OmerNazir/CustomParts/3D/Battery_A_size_3_pin.step

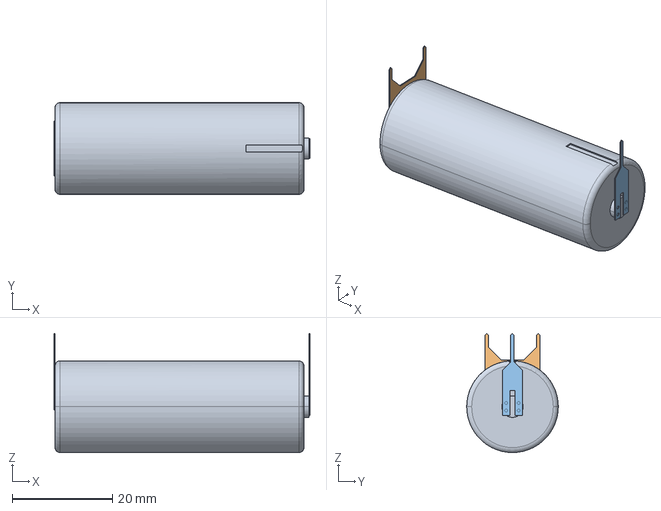
[picture p1: CAD file, 2024-05-29]
3D/Battery_A_size_3_pin.step
51.1 x 18.3 x 23.8 mm
