OmerNazir/CustomParts/3D/Inductor_Custom_1.5mH.step

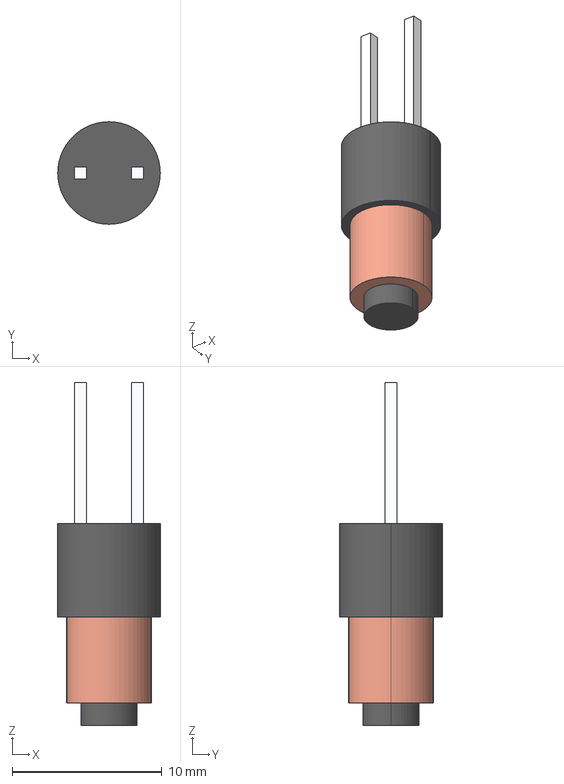
[picture p2: CAD file, 2024-04-29]
3D/Inductor_Custom_1.5mH.step
6.85 x 6.85 x 22.9 mm
