OmerNazir/CustomParts/3D/Connector_Molex_SPOX_5267-03A_1x03_P2.50mm_Vertical.step

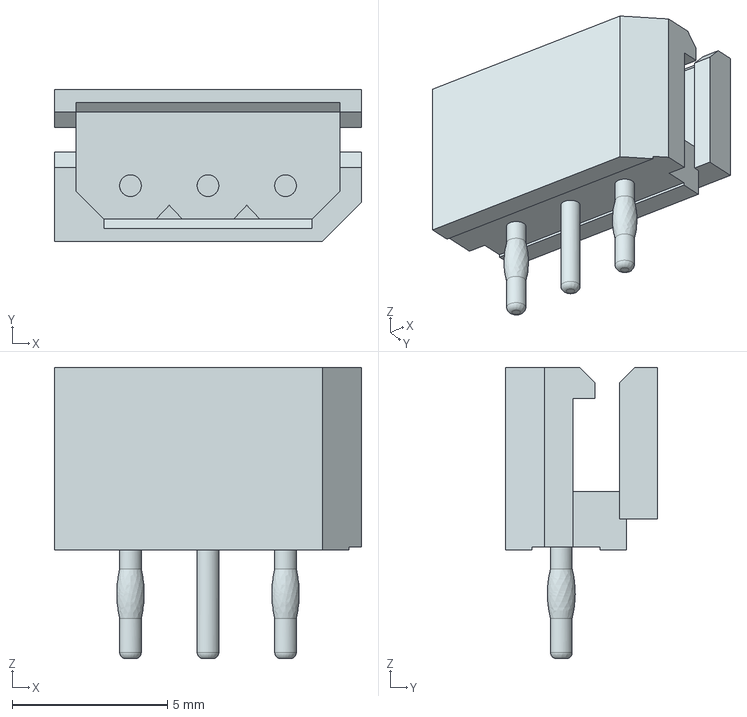
[picture p3: CAD file, 2024-04-16]
3D/Connector_Molex_SPOX_5267-03A_1x03_P2.50mm_Vertical.step
9.90 x 4.90 x 9.40 mm
