OmerNazir/CustomParts/3D/Connector_Molex_SPOX_5267-02A_1x02_P2.50mm_Vertical.step

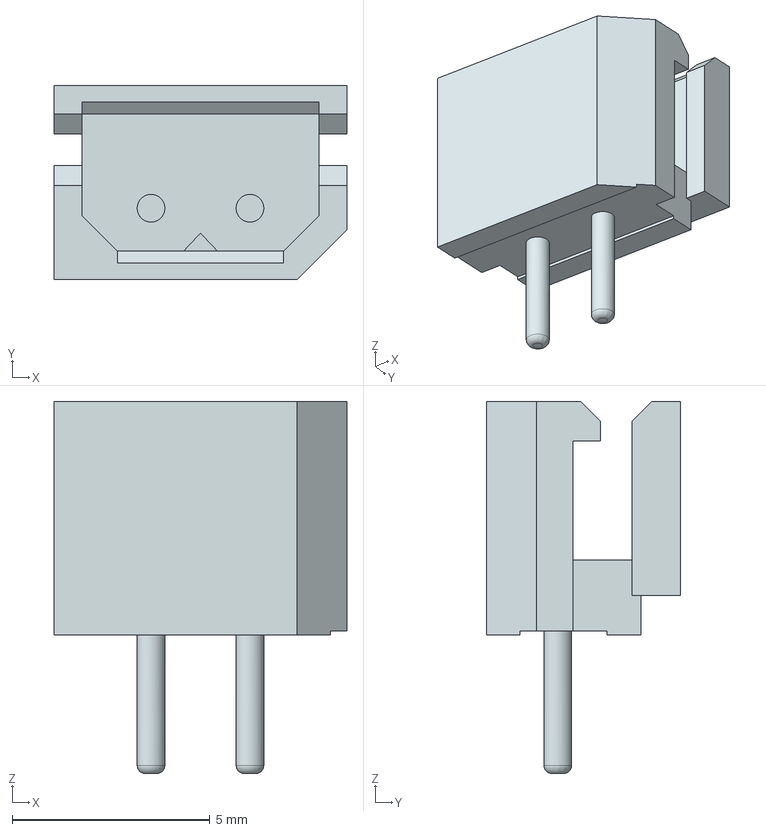
[picture p4: CAD file, 2024-04-16]
3D/Connector_Molex_SPOX_5267-02A_1x02_P2.50mm_Vertical.step
7.40 x 4.90 x 9.40 mm
