OmerNazir/CustomParts/3D/Connector_Molex_SPOX_5267-04A_1x04_P2.50mm_Vertical.step

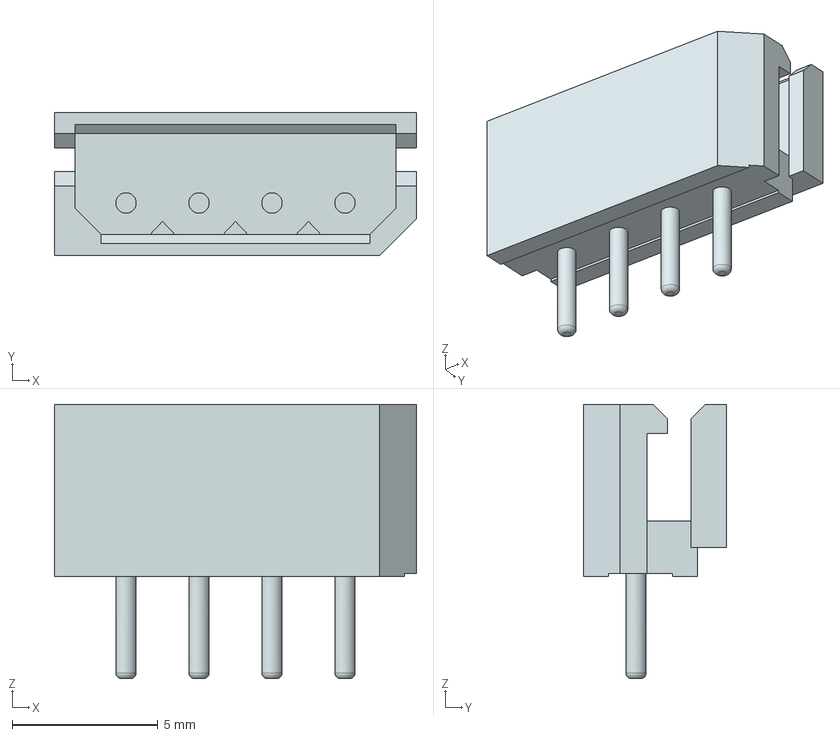
[picture p5: CAD file, 2024-04-16]
3D/Connector_Molex_SPOX_5267-04A_1x04_P2.50mm_Vertical.step
12.4 x 4.90 x 9.40 mm
