OmerNazir/CustomParts/3D/Connector_Molex_SPOX_5267-06A_1x06_P2.50mm_Vertical.step

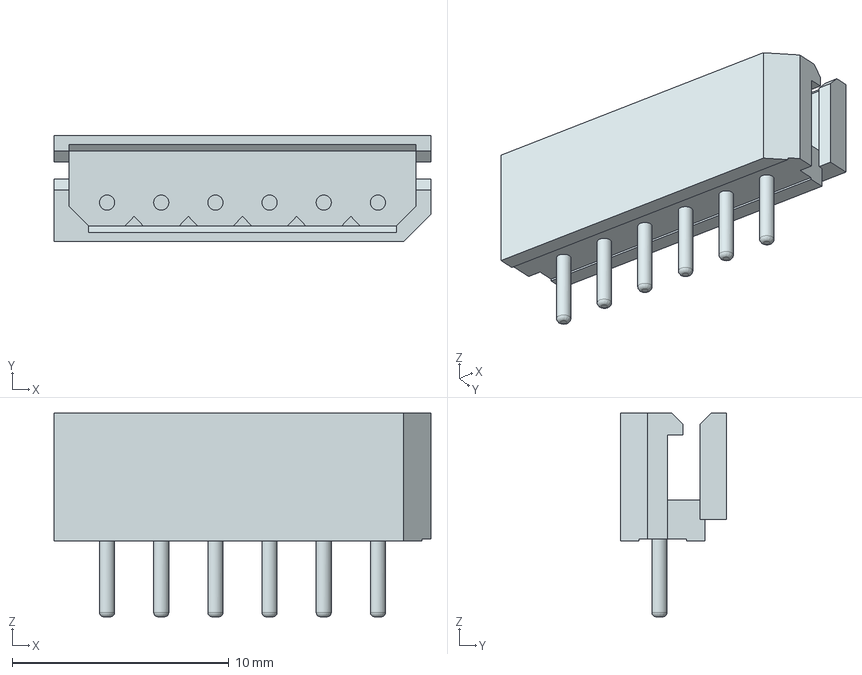
[picture p6: CAD file, 2024-04-16]
3D/Connector_Molex_SPOX_5267-06A_1x06_P2.50mm_Vertical.step
17.4 x 4.90 x 9.40 mm
