OmerNazir/CustomParts/3D/Switch_Micro.step

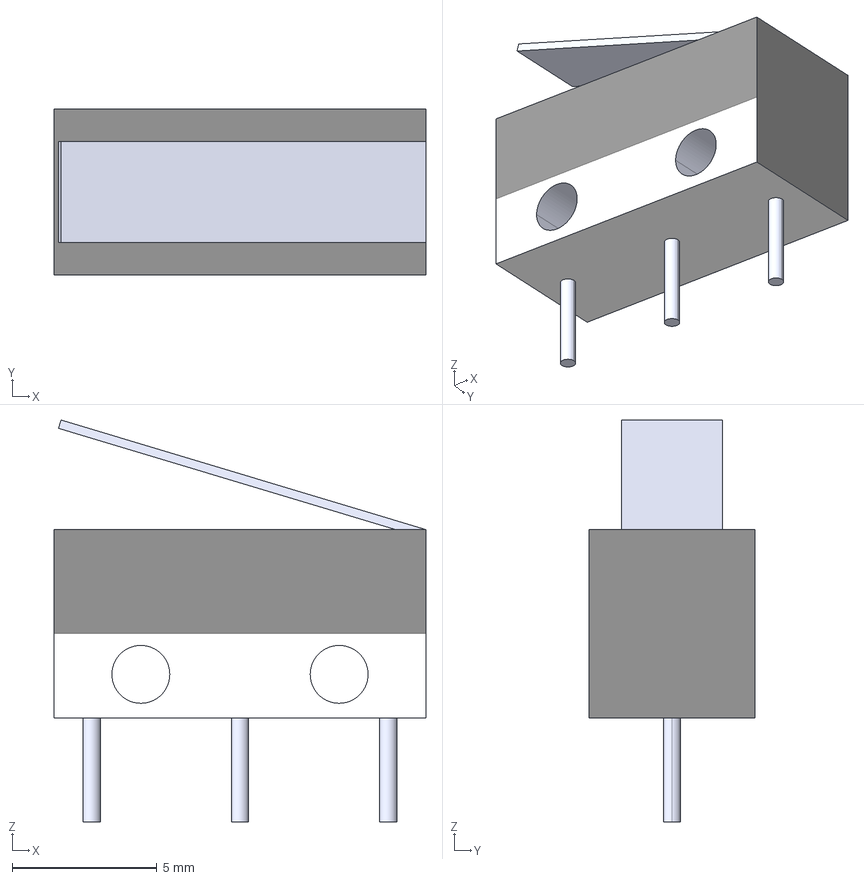
[picture p7: CAD file, 2024-04-16]
3D/Switch_Micro.step
12.9 x 5.75 x 13.9 mm
