OmerNazir/CustomParts/3D/Connector_Molex_SPOX_5267-05A_1x05_P2.50mm_Vertical.step

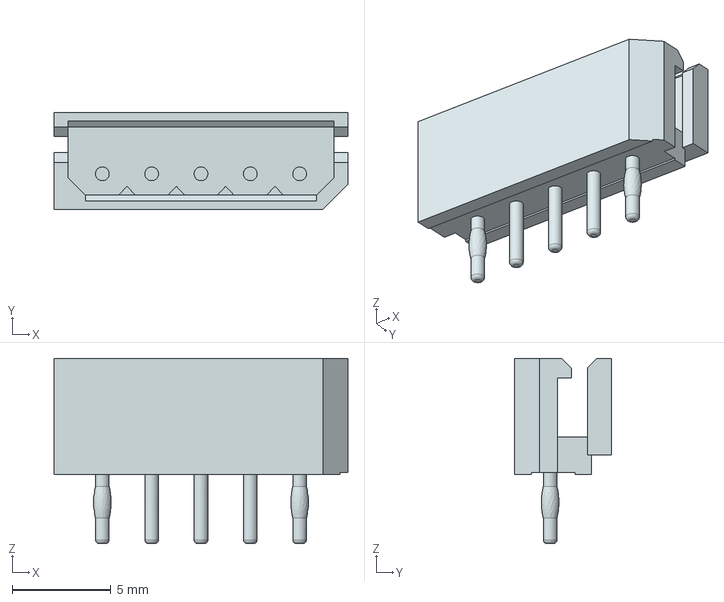
[picture p8: CAD file, 2024-04-16]
3D/Connector_Molex_SPOX_5267-05A_1x05_P2.50mm_Vertical.step
14.9 x 4.90 x 9.40 mm
