OmerNazir/CustomParts/3D/Connector_ETH_1GB_7499511420.step

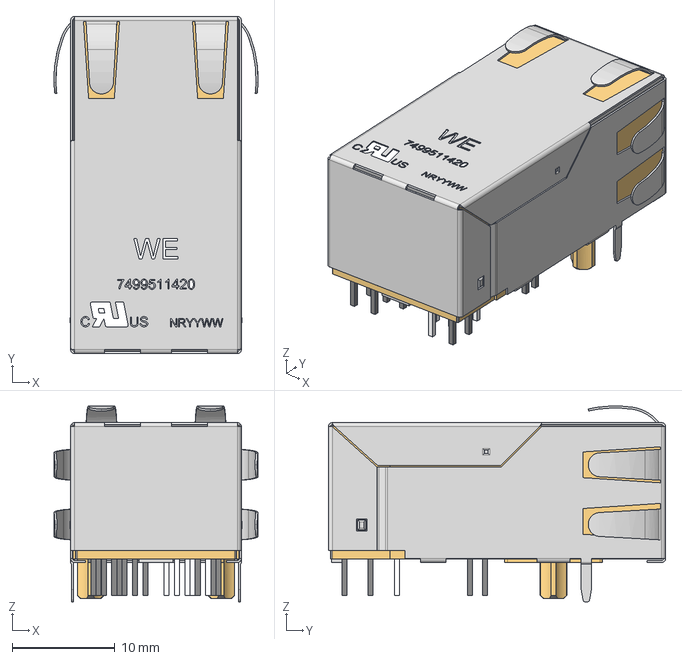
[picture p9: CAD file, 2024-03-22]
3D/Connector_ETH_1GB_7499511420.step
19.8 x 32.8 x 19.0 mm
