OmerNazir/CustomParts/3D/USB_TYPE_B_AMPHENOL_61729-0010BLF.STEP

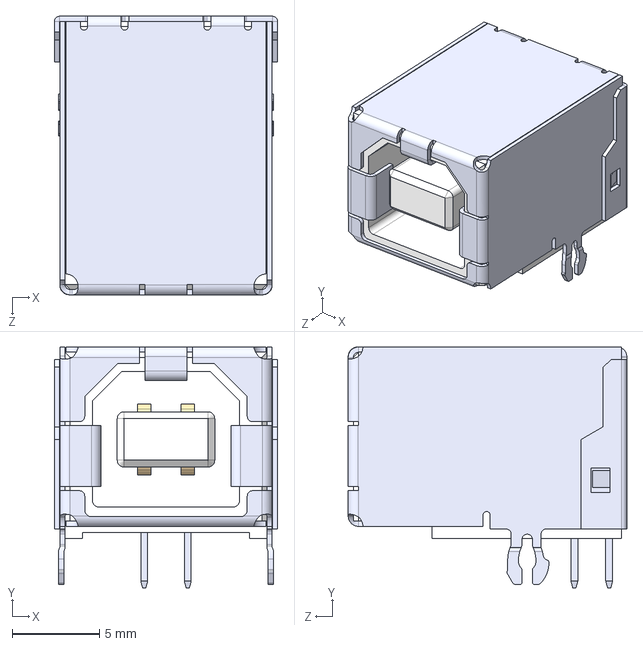
[picture p10: CAD file, 2024-03-22]
3D/USB_TYPE_B_AMPHENOL_61729-0010BLF.STEP
12.8 x 13.8 x 16.0 mm
