OmerNazir/CustomParts/3D/QFP44- 10x10.STEP

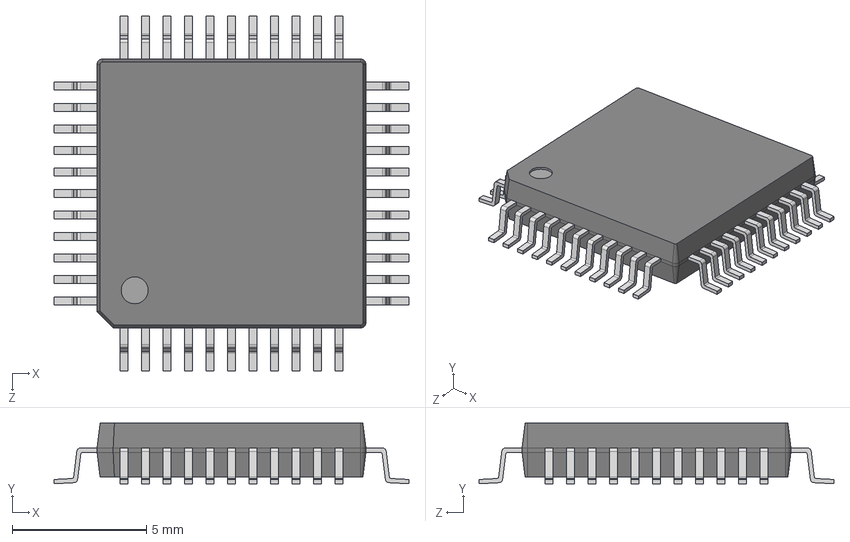
[picture p11: CAD file, 2024-03-22]
3D/QFP44- 10x10.STEP
13.2 x 2.25 x 13.2 mm
