OmerNazir/CustomParts/3D/Tact Switch 4.5mm SMT.step

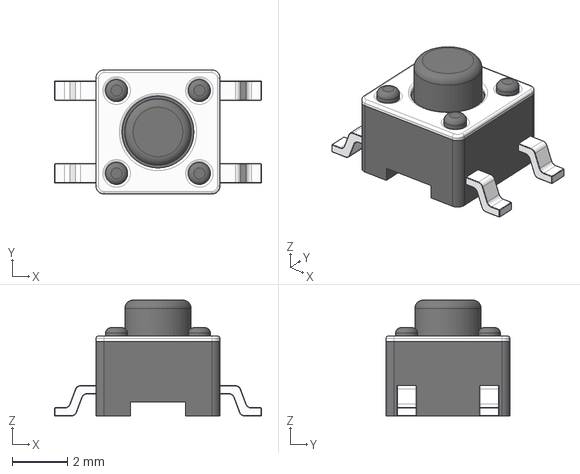
[picture p12: CAD file, 2024-03-22]
3D/Tact Switch 4.5mm SMT.step
7.50 x 4.50 x 4.20 mm
