OmerNazir/CustomParts/3D/MAX3232ECTET.step

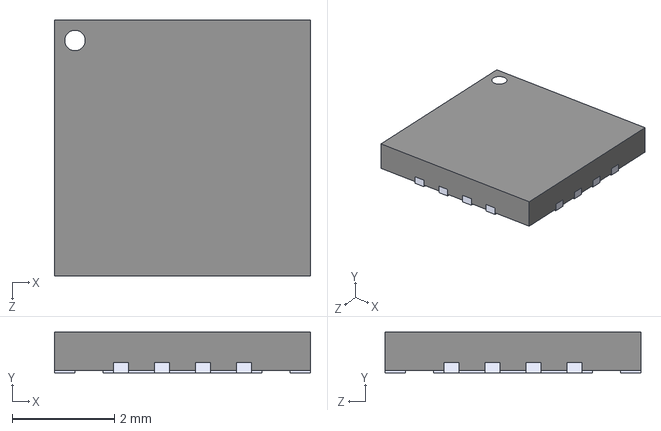
[picture p13: CAD file, 2024-03-22]
3D/MAX3232ECTET.step
5.00 x 0.8 x 5.00 mm
