OmerNazir/CustomParts/3D/HDMI_A_AMPHENOL_10029449-111RLF.step

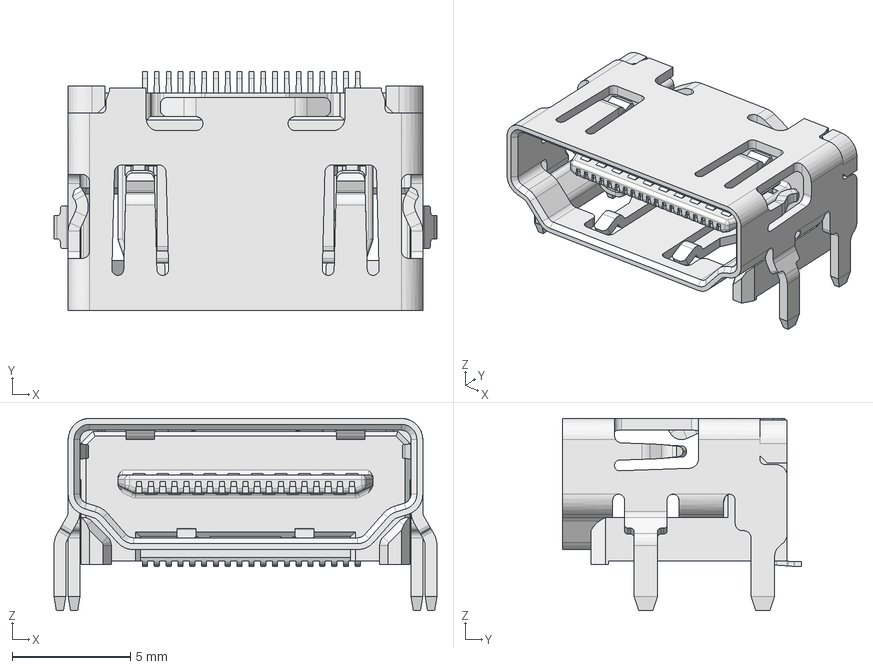
[picture p14: CAD file, 2024-03-22]
3D/HDMI_A_AMPHENOL_10029449-111RLF.step
16.2 x 10.1 x 8.13 mm
