OmerNazir/CustomParts/3D/LAN_TRANSFORMER_7490220122_WRE.step

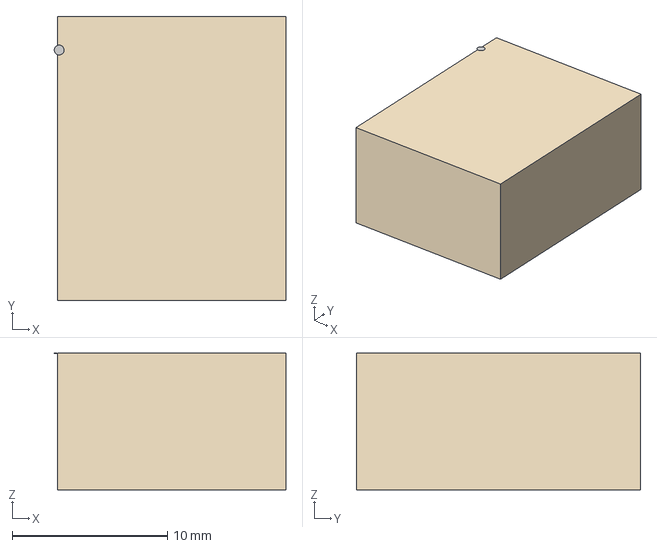
[picture p15: CAD file, 2024-03-22]
3D/LAN_TRANSFORMER_7490220122_WRE.step
14.9 x 18.3 x 8.82 mm
