OmerNazir/CustomParts/3D/connector_BarrelJack_GCT_DCJ200_10_A_Horizontal.step

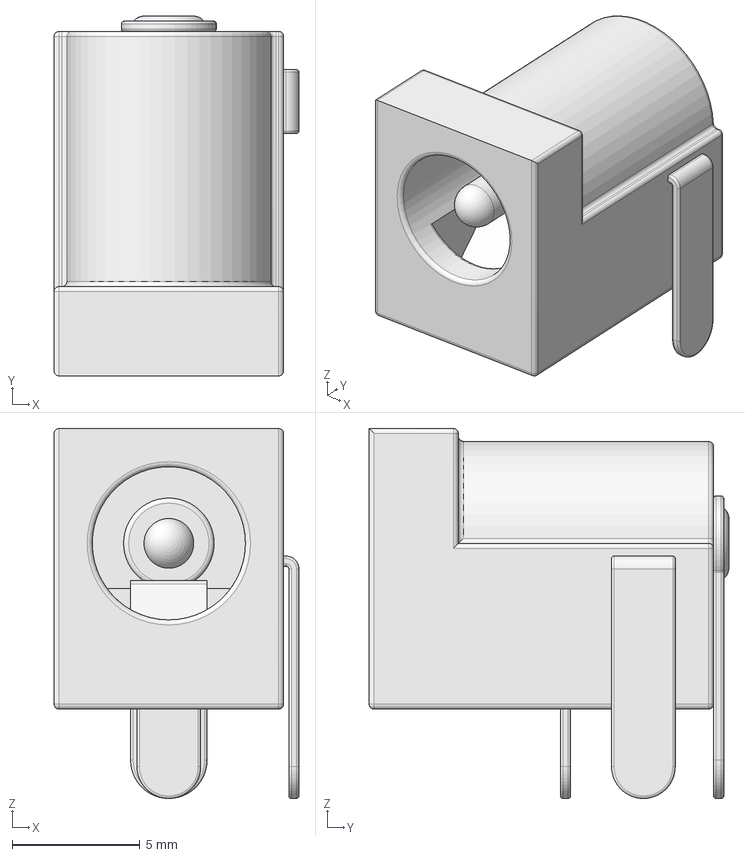
[picture p16: CAD file, 2024-03-22]
3D/connector_BarrelJack_GCT_DCJ200_10_A_Horizontal.step
9.60 x 14.1 x 14.5 mm
