OmerNazir/CustomParts/3D/USB_A_DOUBLE_STACK_61400826021 (rev1).stp

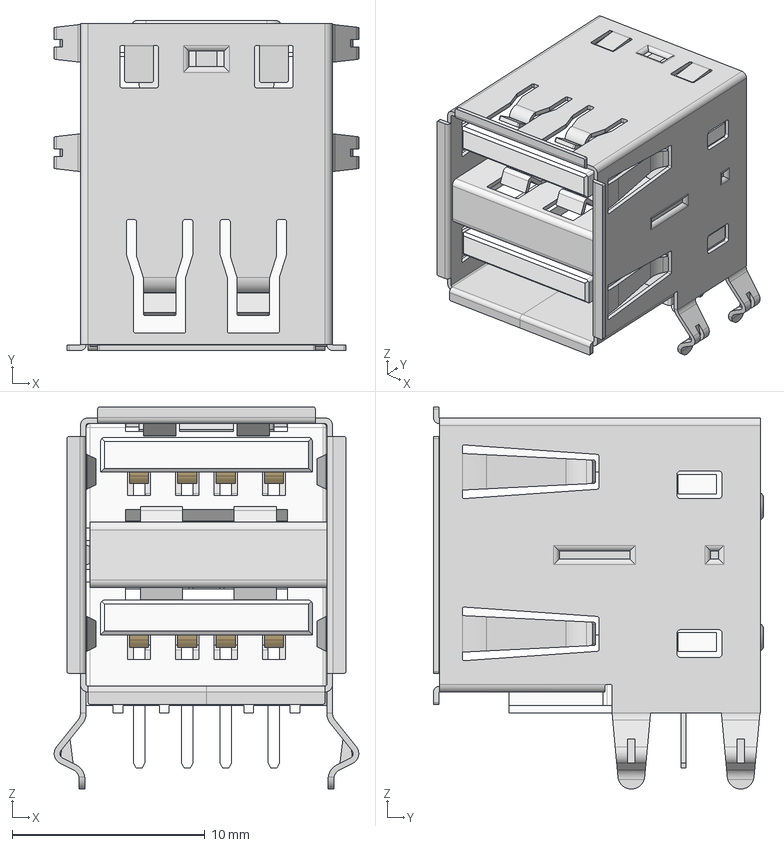
[picture p17: CAD file, 2024-03-22]
3D/USB_A_DOUBLE_STACK_61400826021 (rev1).stp
15.8 x 17.1 x 19.8 mm
61400826021_Shielding1
61400826021_Housing
61400826021_Shielding2
61400826021_Pin2 x 4
61400826021_Pin1 x 4
61400826021_Shielding3
