OmerNazir/CustomParts/3D/Filter_LCC_NFE61PT472C1H9L.step

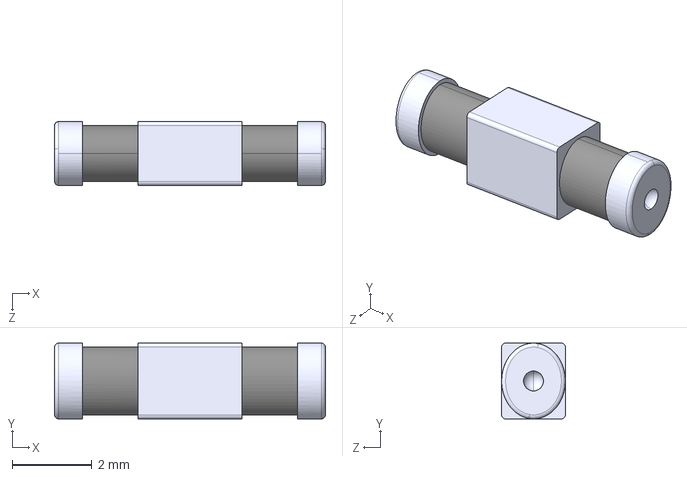
[picture p18: CAD file, 2024-03-22]
3D/Filter_LCC_NFE61PT472C1H9L.step
6.80 x 1.90 x 1.60 mm
