OmerNazir/CustomParts/3D/64-LFCSP-VQ (9x9)_CP_64_3_ADI.step

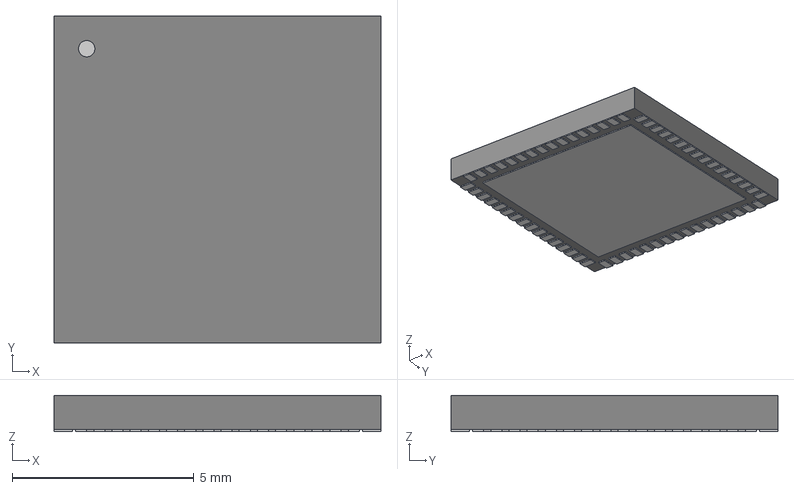
[picture p19: CAD file, 2024-03-22]
3D/64-LFCSP-VQ (9x9)_CP_64_3_ADI.step
8.99 x 8.99 x 0.993 mm
