OmerNazir/CustomParts/3D/Connector_USB_Micro-B_Wuerth_629105150521.step

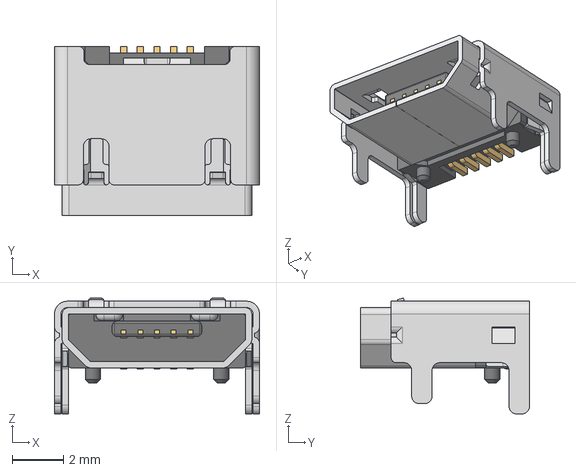
[picture p20: CAD file, 2024-03-22]
3D/Connector_USB_Micro-B_Wuerth_629105150521.step
8.00 x 6.60 x 4.52 mm
