OmerNazir/CustomParts/3D/Battery_Pulse_SPC1550.step

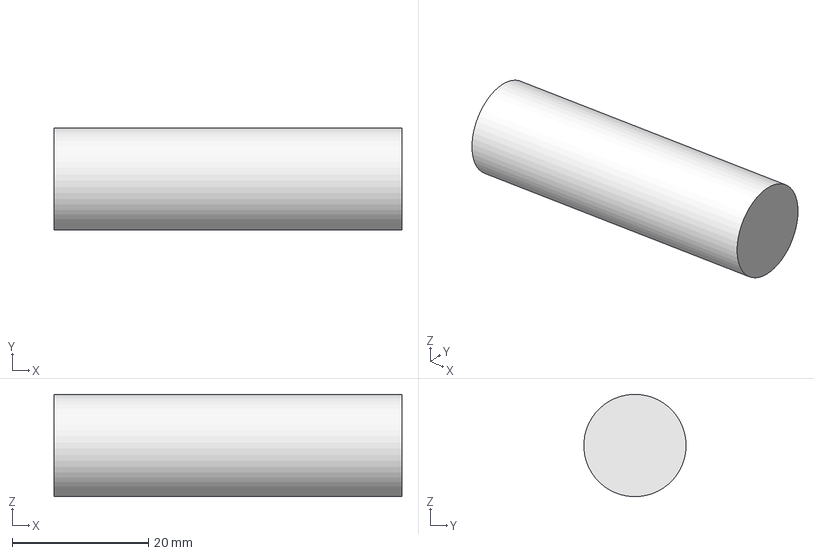
[picture p21: CAD file, 2024-03-22]
3D/Battery_Pulse_SPC1550.step
51.0 x 15.0 x 15.0 mm
