OmerNazir/CustomParts/3D/SOD882.step

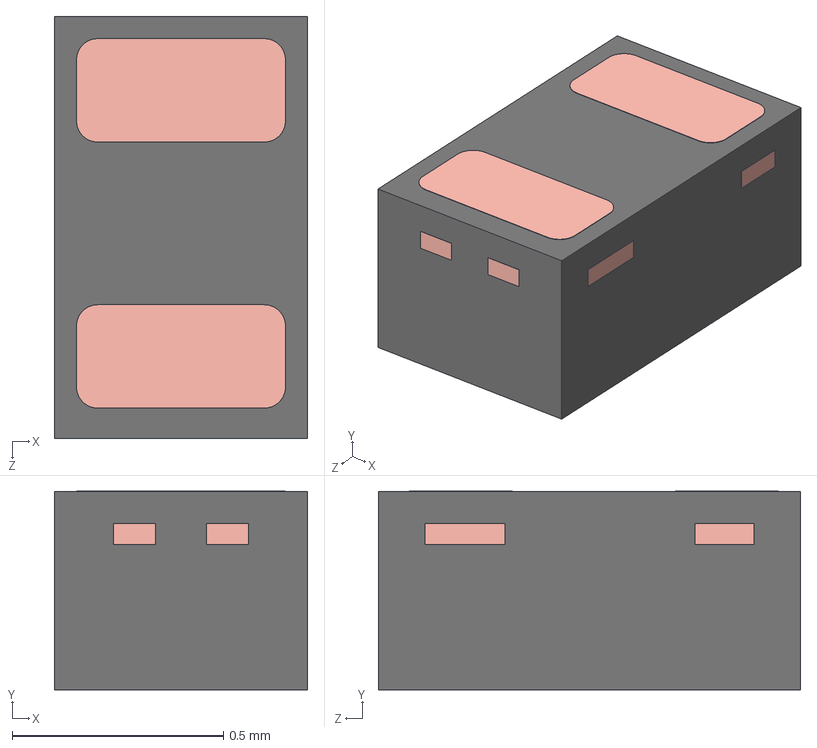
[picture p22: CAD file, 2024-03-22]
3D/SOD882.step
0.6 x 0.471 x 1.00 mm
SOD882 body
SOD882A3 singulated LF unit
