OmerNazir/CustomParts/3D/Filter_CMC_SMD_wurth_744272251.step

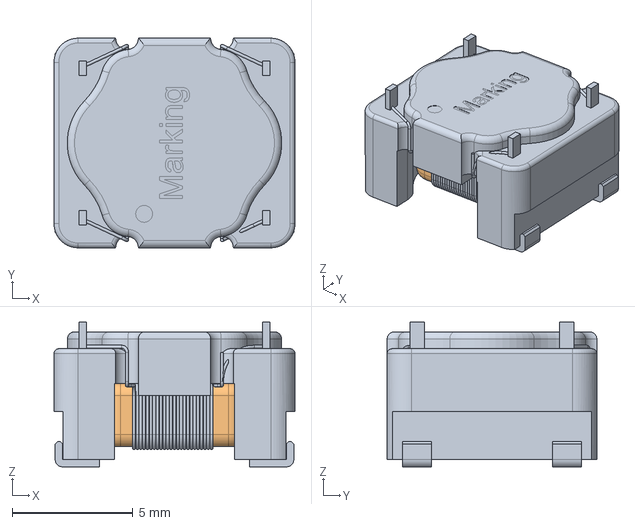
[picture p23: CAD file, 2024-03-22]
3D/Filter_CMC_SMD_wurth_744272251.step
10.0 x 8.70 x 6.00 mm
