OmerNazir/CustomParts/3D/Fuse_Holder_LittleFuse_64600001223.step

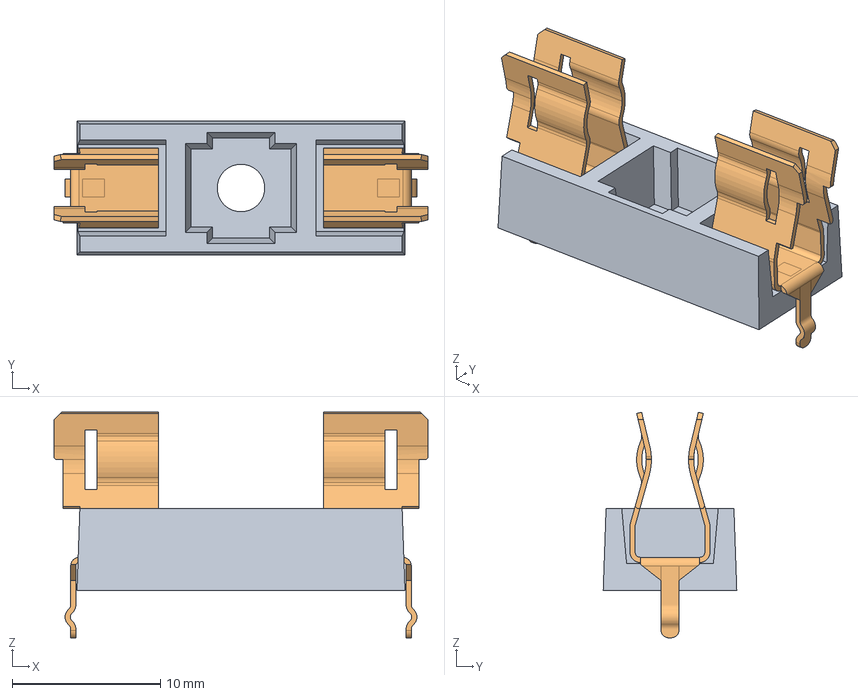
[picture p24: CAD file, 2024-03-22]
3D/Fuse_Holder_LittleFuse_64600001223.step
25.2 x 9.00 x 15.2 mm
