OmerNazir/CustomParts/3D/SLP1616P6_SEM.step

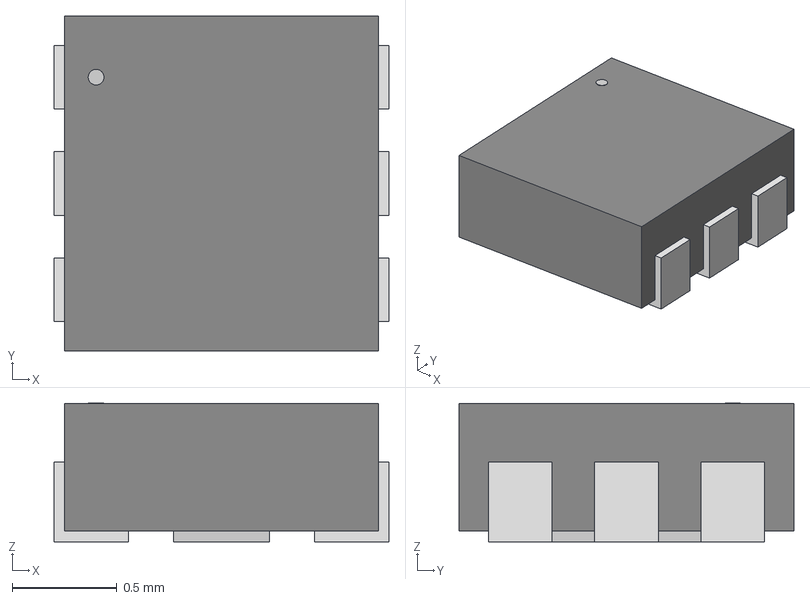
[picture p25: CAD file, 2024-03-22]
3D/SLP1616P6_SEM.step
1.60 x 1.60 x 0.663 mm
