OmerNazir/CustomParts/3D/TVS_RCLAMP0524PATCT.step

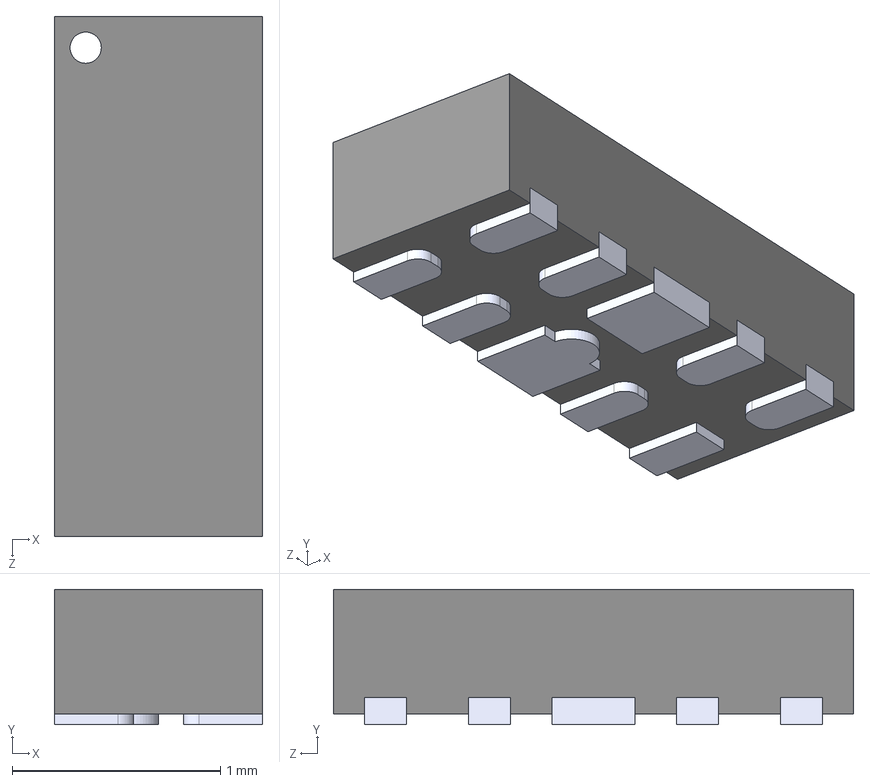
[picture p26: CAD file, 2024-03-22]
3D/TVS_RCLAMP0524PATCT.step
1.00 x 0.65 x 2.50 mm
