OmerNazir/CustomParts/3D/STM32F411CEU6.step

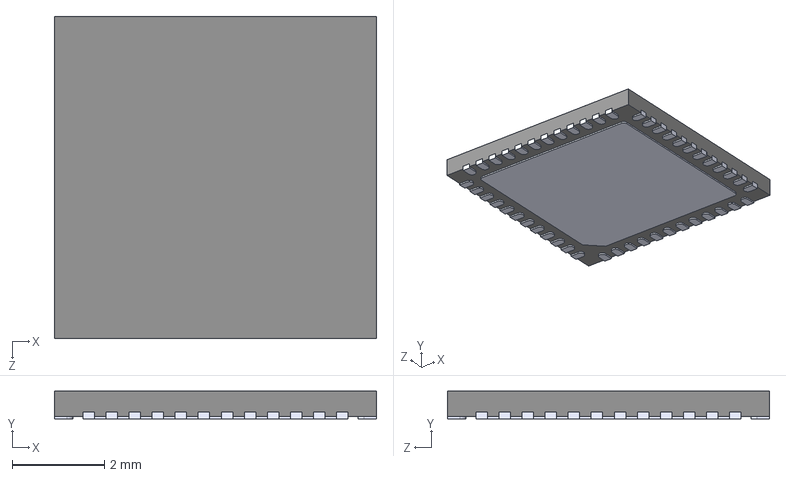
[picture p27: CAD file, 2024-03-22]
3D/STM32F411CEU6.step
7.00 x 0.6 x 7.00 mm
