OmerNazir/CustomParts/3D/IC_SM-8_DCT0008A.stp

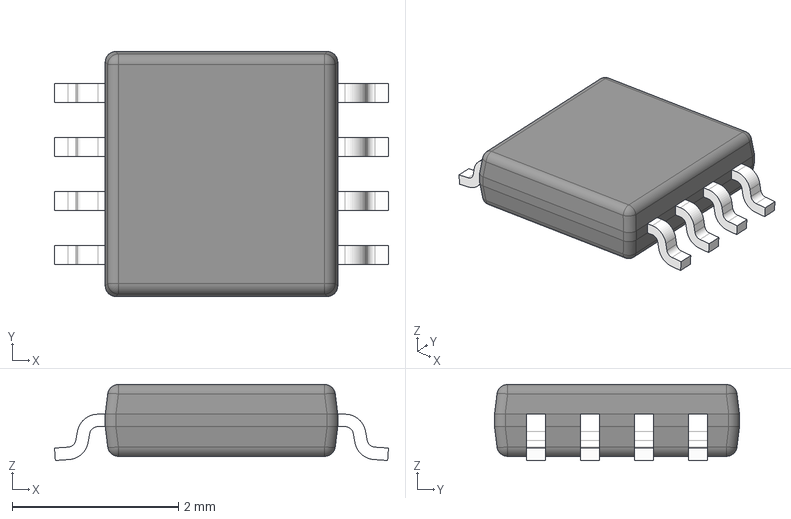
[picture p28: CAD file, 2024-03-22]
3D/IC_SM-8_DCT0008A.stp
4.02 x 2.95 x 0.915 mm
BODY-SO
LEAD-SO x 8
PIN1-ID
