OmerNazir/CustomParts/3D/Connector_SMD_MOLEX_533980471.step

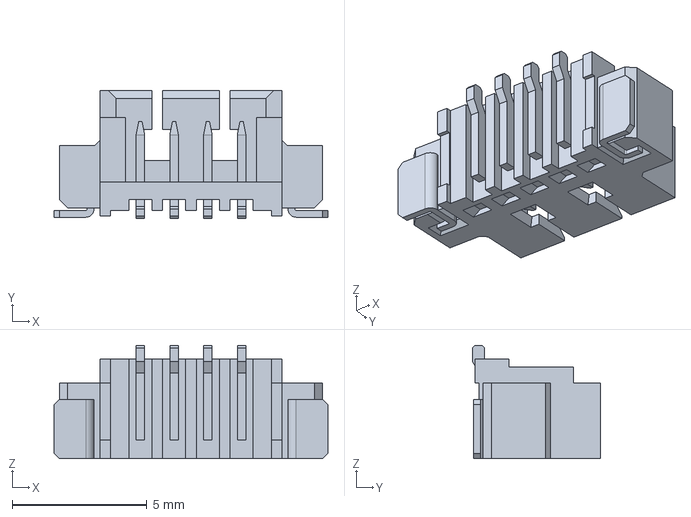
[picture p29: CAD file, 2024-03-22]
3D/Connector_SMD_MOLEX_533980471.step
10.1 x 4.75 x 4.20 mm
