OmerNazir/CustomParts/3D/Steel Spacer_9774025151R.step

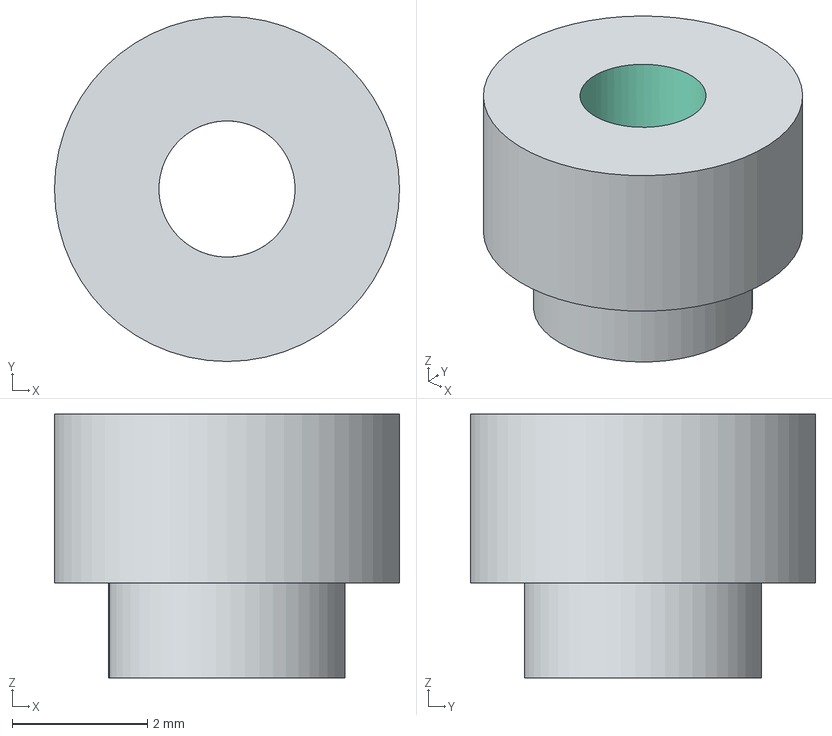
[picture p30: CAD file, 2024-03-22]
3D/Steel Spacer_9774025151R.step
5.10 x 5.10 x 3.90 mm
