OmerNazir/CustomParts/3D/Connector_Audio_CUI_DEVICES_SJ1-3523N.step

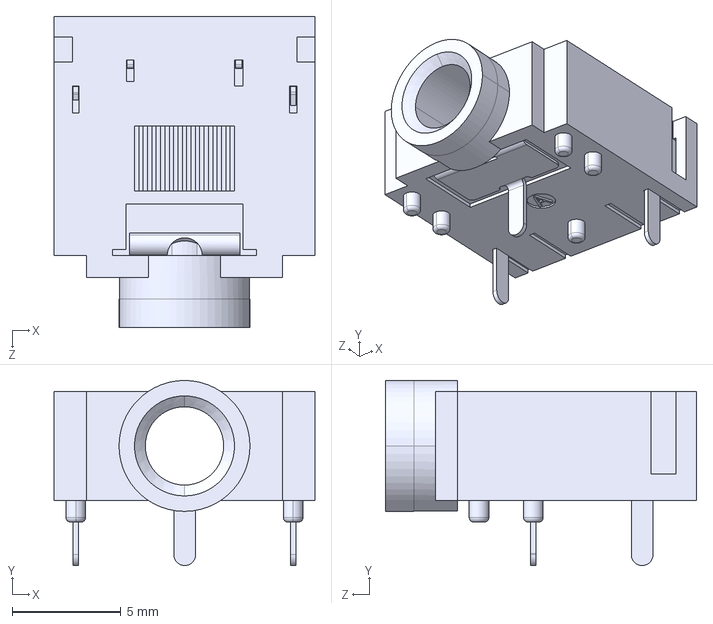
[picture p31: CAD file, 2024-03-22]
3D/Connector_Audio_CUI_DEVICES_SJ1-3523N.step
12.0 x 8.51 x 14.3 mm
