OmerNazir/CustomParts/3D/SOT-89-1.STEP

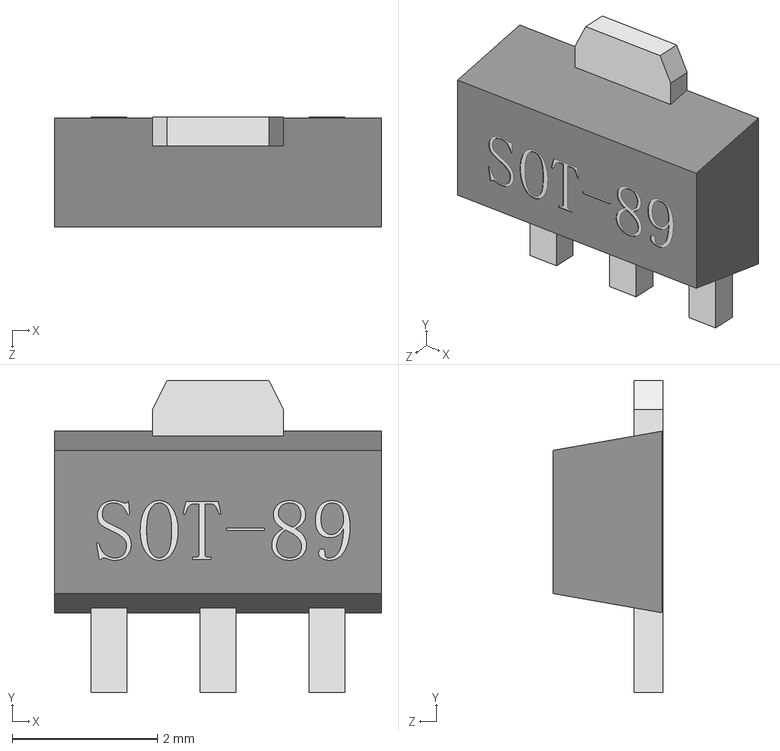
[picture p32: CAD file, 2024-03-22]
3D/SOT-89-1.STEP
4.50 x 4.30 x 1.51 mm
