OmerNazir/CustomParts/3D/IC_QFN_Package_VQFN-HR (RJE)_20.step

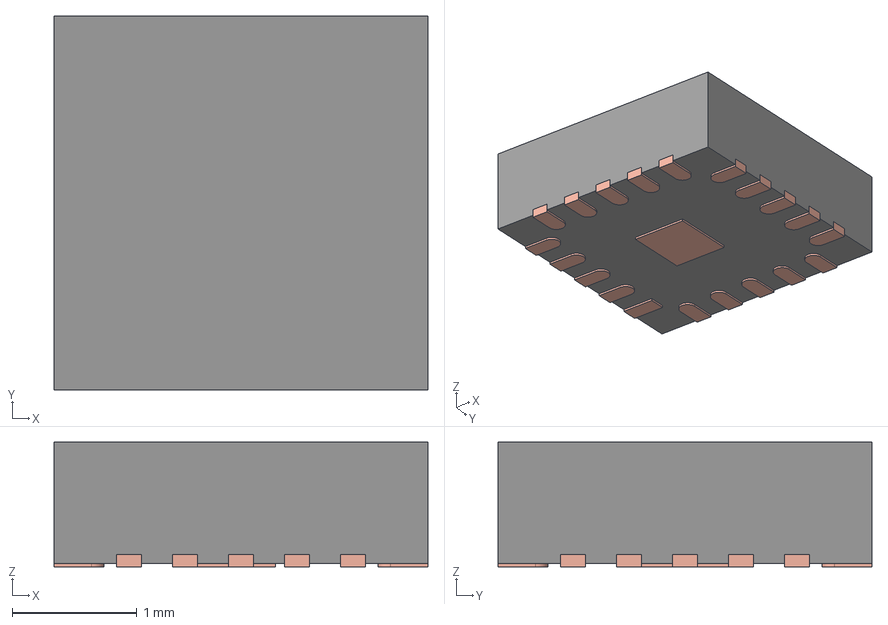
[picture p33: CAD file, 2024-03-22]
3D/IC_QFN_Package_VQFN-HR (RJE)_20.step
3.00 x 3.00 x 1.00 mm
FRAME
