OmerNazir/CustomParts/3D/bc_260_1.step

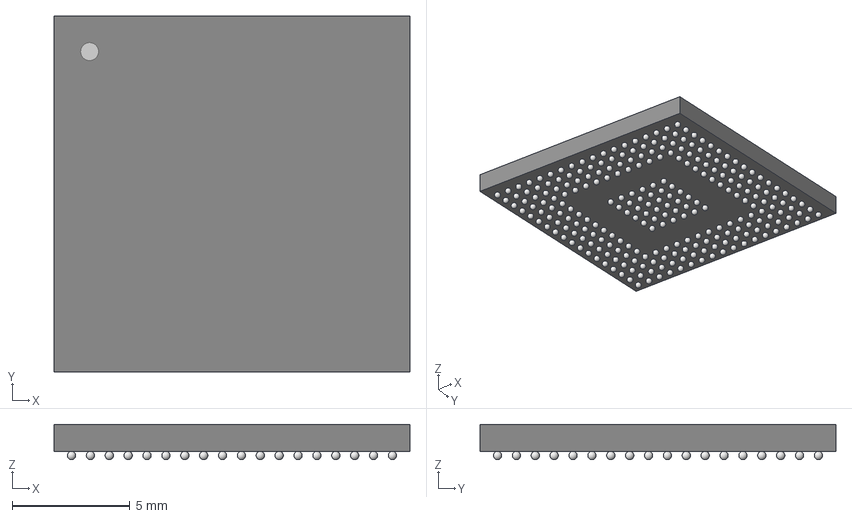
[picture p34: CAD file, 2024-03-22]
3D/bc_260_1.step
15.1 x 15.1 x 1.50 mm
