OmerNazir/CustomParts/3D/RES_ADJ_3386P-1-202LF.STEP

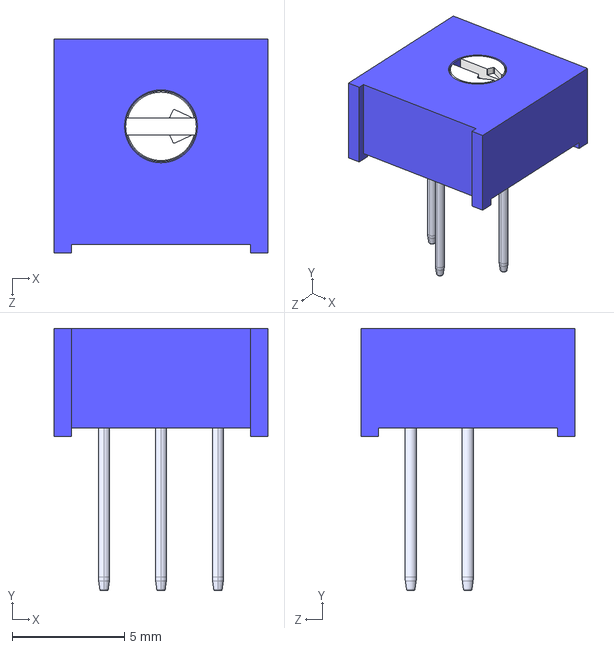
[picture p35: CAD file, 2024-03-22]
3D/RES_ADJ_3386P-1-202LF.STEP
9.53 x 11.7 x 9.53 mm
