OmerNazir/CustomParts/3D/IC_RTW0024B.stp

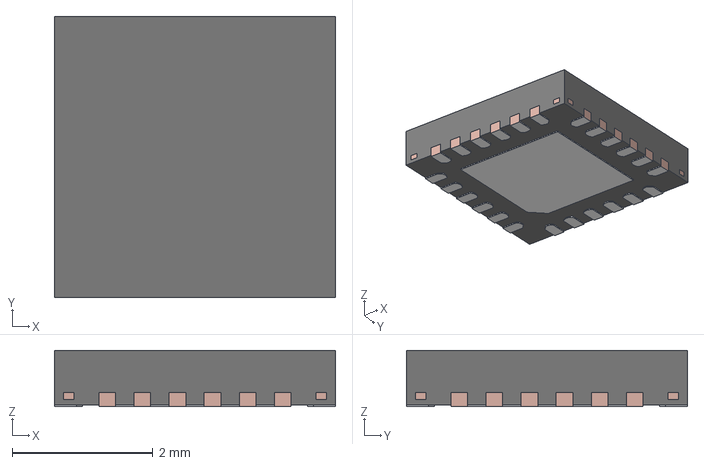
[picture p36: CAD file, 2024-03-22]
3D/IC_RTW0024B.stp
4.00 x 4.00 x 0.8 mm
FRAME
