OmerNazir/CustomParts/3D/Module_DCDC_Converter_CUI_PDQE20-Q48-D12-D.step

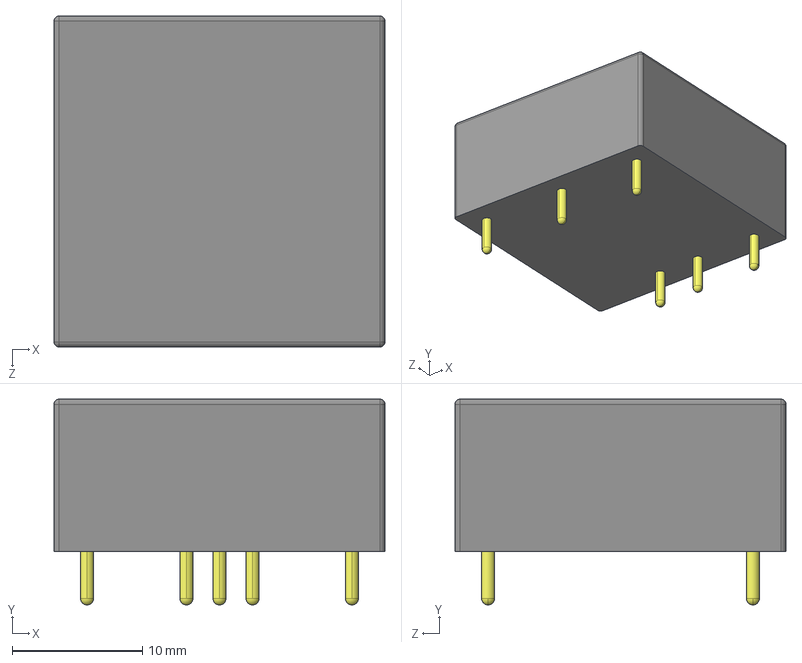
[picture p37: CAD file, 2024-03-22]
3D/Module_DCDC_Converter_CUI_PDQE20-Q48-D12-D.step
25.4 x 15.8 x 25.4 mm
