OmerNazir/CustomParts/3D/Connector_USB3_A_Receptacle_Wuerth_692122030100.step

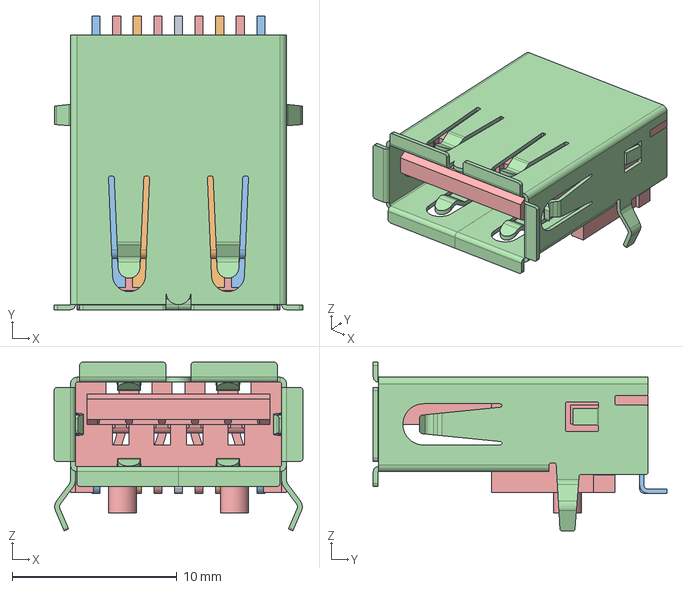
[picture p38: CAD file, 2024-03-22]
3D/Connector_USB3_A_Receptacle_Wuerth_692122030100.step
15.1 x 17.8 x 10.2 mm
