OmerNazir/CustomParts/3D/User Library-Telit GL865.step

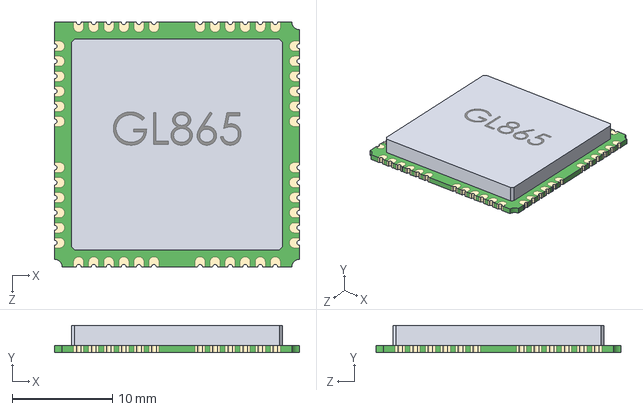
[picture p39: CAD file, 2024-03-22]
3D/User Library-Telit GL865.step
24.4 x 2.71 x 24.4 mm
