OmerNazir/CustomParts/3D/Battery_Pulse_SPC0920.step

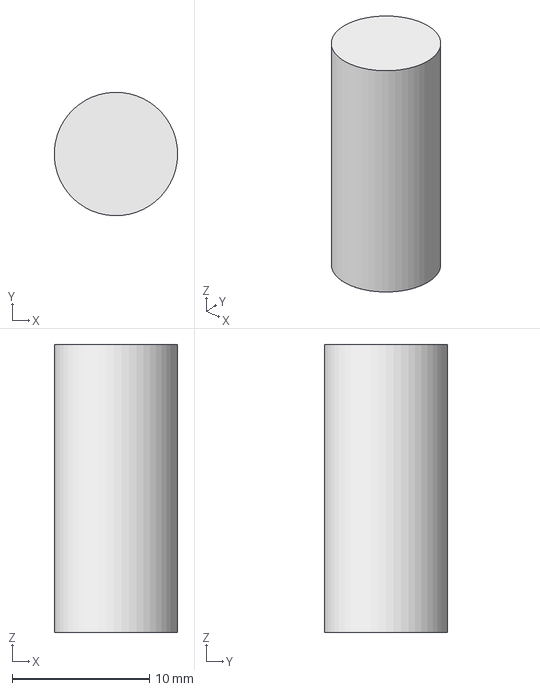
[picture p40: CAD file, 2024-03-22]
3D/Battery_Pulse_SPC0920.step
8.99 x 9.00 x 21.0 mm
