OmerNazir/CustomParts/3D/SOD323F.step

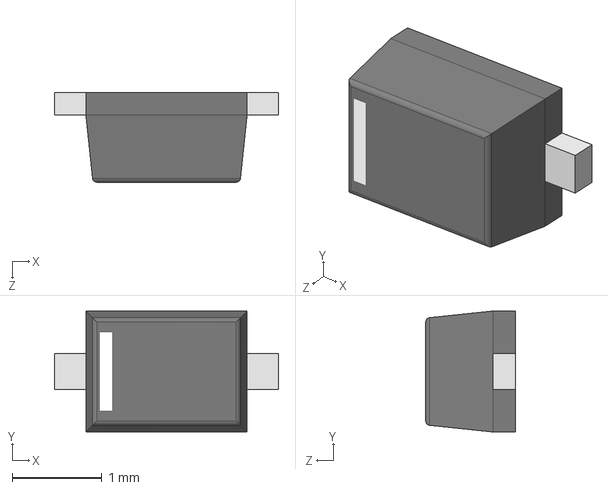
[picture p41: CAD file, 2024-03-22]
3D/SOD323F.step
2.50 x 1.35 x 1.00 mm
