OmerNazir/CustomParts/3D/Connector_TE_M2_1-2199230-6.step

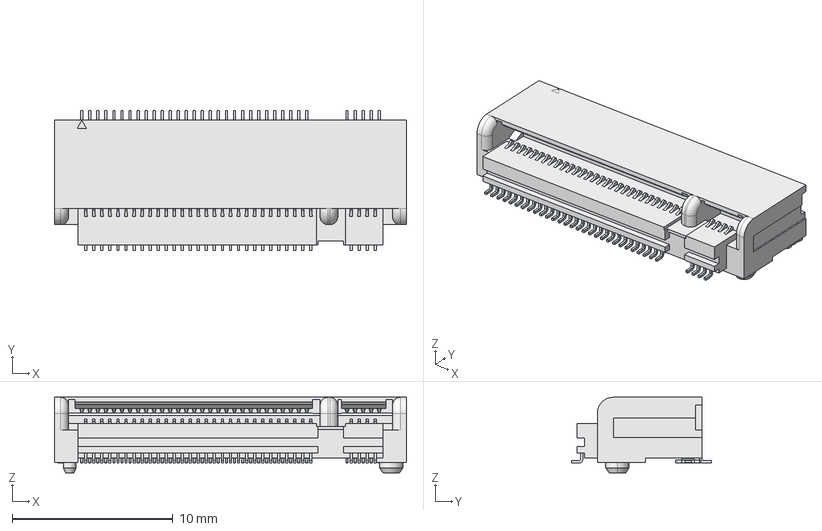
[picture p42: CAD file, 2024-03-22]
3D/Connector_TE_M2_1-2199230-6.step
21.9 x 8.70 x 4.70 mm
