OmerNazir/CustomParts/3D/Connector_WR-TBL Series 3074 - 7.62 mm Reversed Gender Vertical PCB Header__691307400002.step

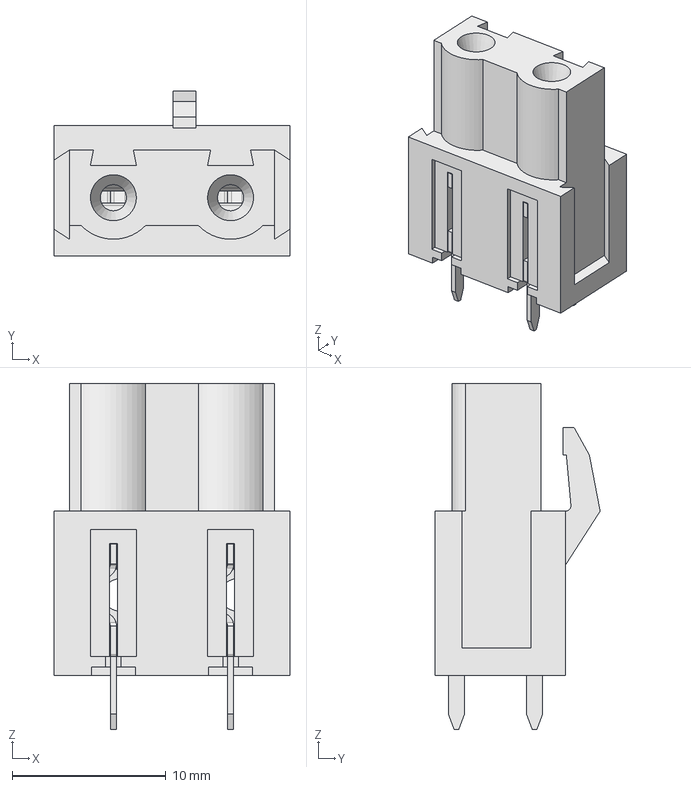
[picture p43: CAD file, 2024-03-22]
3D/Connector_WR-TBL Series 3074 - 7.62 mm Reversed Gender Vertical PCB Header__691307400002.step
15.3 x 10.8 x 22.5 mm
