OmerNazir/CustomParts/3D/Fuse_Holder_wurth_696310001002.step

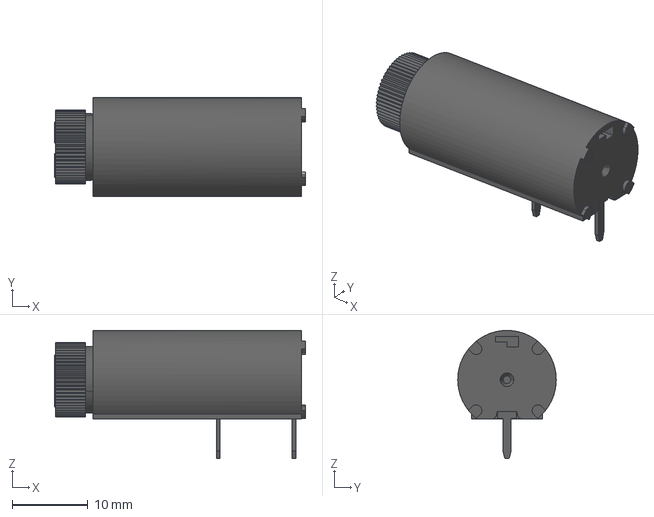
[picture p44: CAD file, 2024-03-22]
3D/Fuse_Holder_wurth_696310001002.step
33.1 x 13.0 x 16.9 mm
