OmerNazir/CustomParts/3D/Pil ctechi.STEP

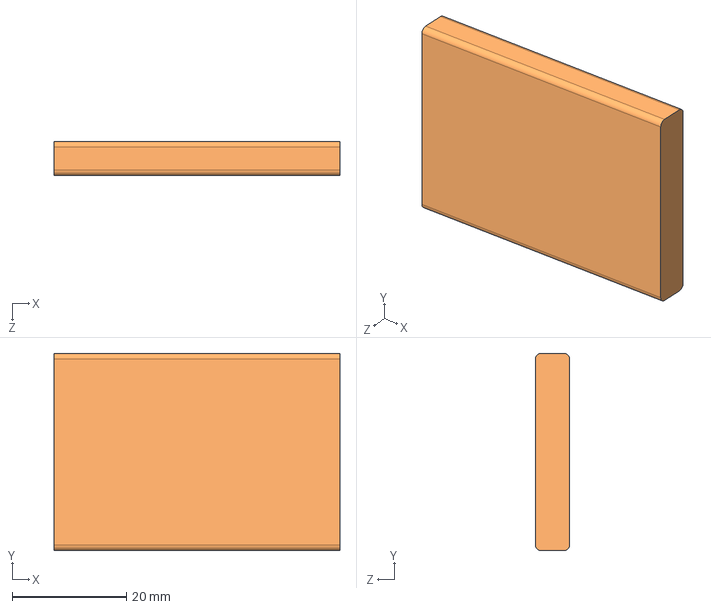
[picture p45: CAD file, 2024-03-22]
3D/Pil ctechi.STEP
50.0 x 34.5 x 6.00 mm
