OmerNazir/CustomParts/3D/LED-00004 Led Red TH 3mm Iv400mcd.step

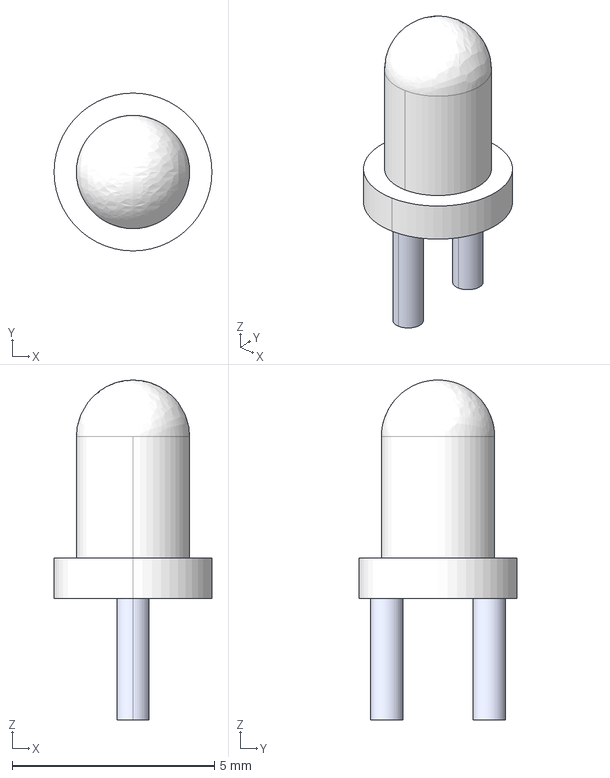
[picture p46: CAD file, 2024-03-22]
3D/LED-00004 Led Red TH 3mm Iv400mcd.step
3.90 x 3.90 x 8.40 mm
