OmerNazir/CustomParts/3D/Connector_Audio_SJ-3523-SMT-TR.step

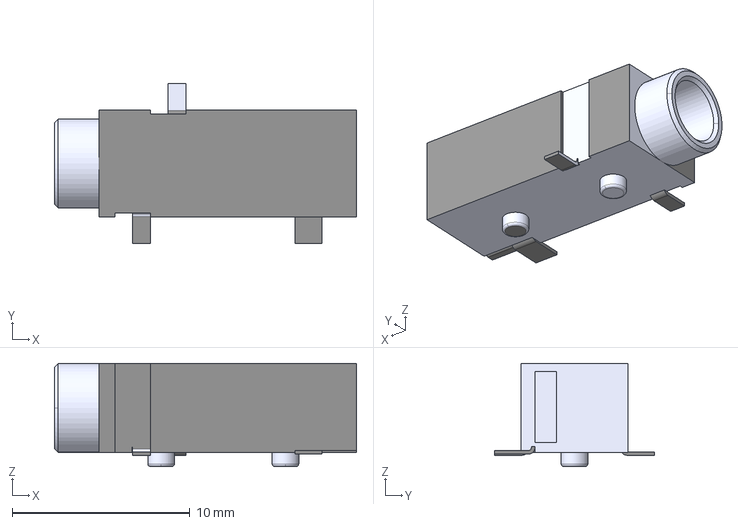
[picture p47: CAD file, 2024-03-22]
3D/Connector_Audio_SJ-3523-SMT-TR.step
17.0 x 9.00 x 5.80 mm
