OmerNazir/CustomParts/3D/TSOT-23-6(S6).STEP

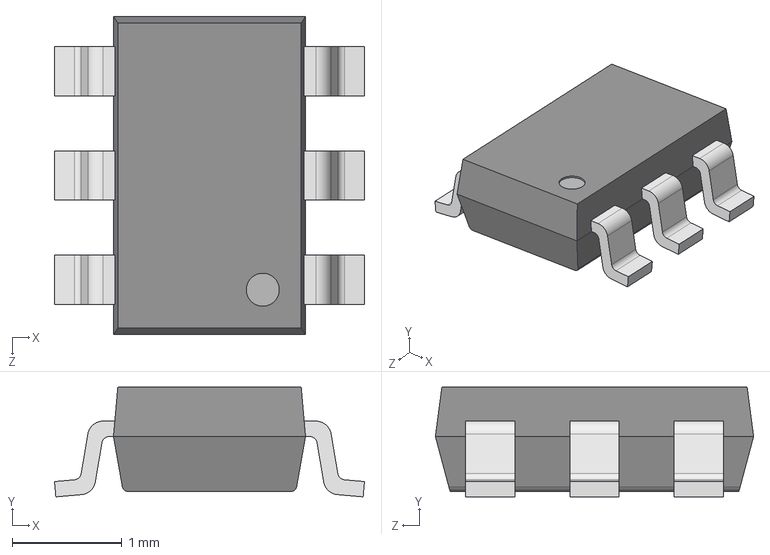
[picture p48: CAD file, 2024-03-22]
3D/TSOT-23-6(S6).STEP
2.82 x 1.00 x 2.90 mm
