OmerNazir/CustomParts/3D/User Library-SIM holder R5190008-X33(4)-R.step

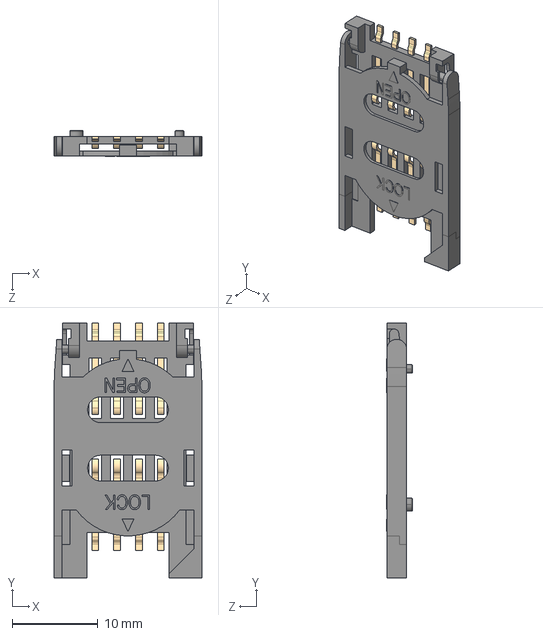
[picture p49: CAD file, 2024-03-22]
3D/User Library-SIM holder R5190008-X33(4)-R.step
17.2 x 29.7 x 3.05 mm
