OmerNazir/CustomParts/3D/Module_M2_2242.step

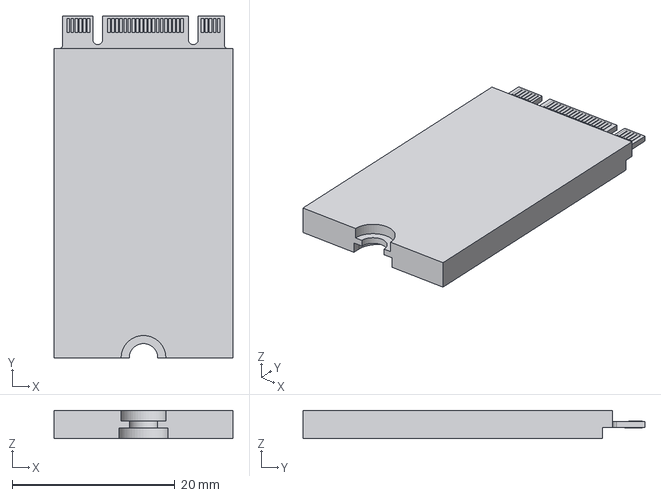
[picture p50: CAD file, 2024-03-22]
3D/Module_M2_2242.step
22.0 x 42.0 x 3.50 mm
