OmerNazir/CustomParts/3D/IC_20-VQFN (5x5)_TPS2372.stp

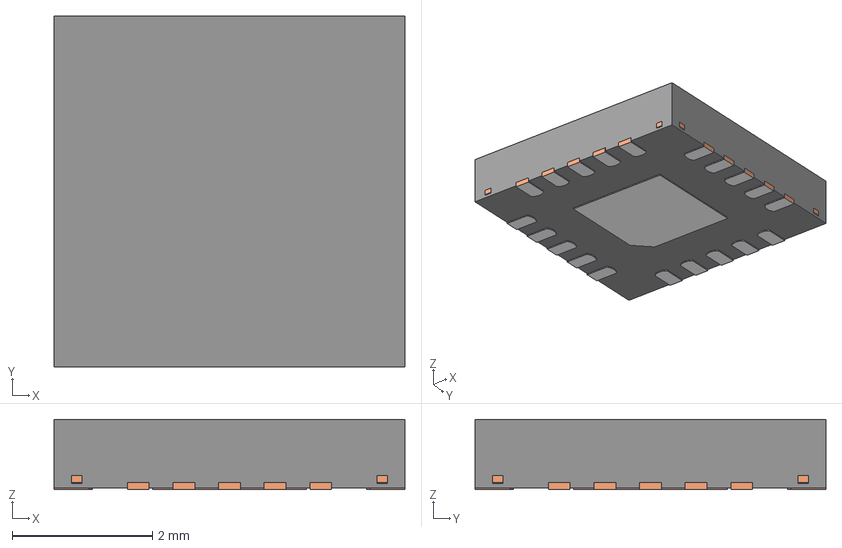
[picture p51: CAD file, 2024-03-22]
3D/IC_20-VQFN (5x5)_TPS2372.stp
5.00 x 5.00 x 1.00 mm
BODY-QFN
FRAME-RGW0020B
PIN1-ID
