OmerNazir/CustomParts/3D/Connector_TERM BLOCK HDR 2POS VERT 5.08MM_1785942.step

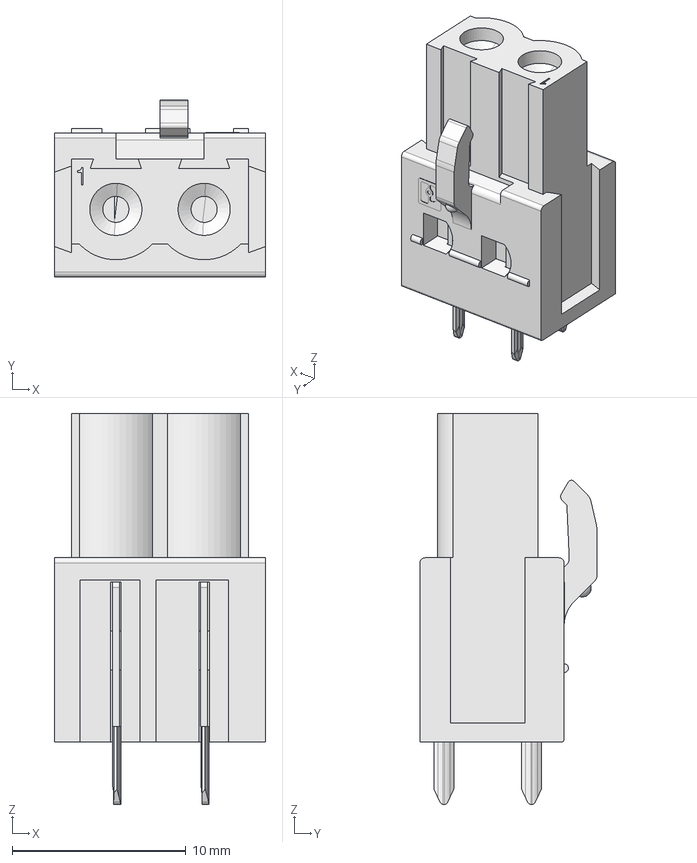
[picture p52: CAD file, 2024-03-22]
3D/Connector_TERM BLOCK HDR 2POS VERT 5.08MM_1785942.step
12.2 x 10.2 x 22.5 mm
