OmerNazir/CustomParts/3D/QFN24_W-QFN4040-24_A1_DIO.step

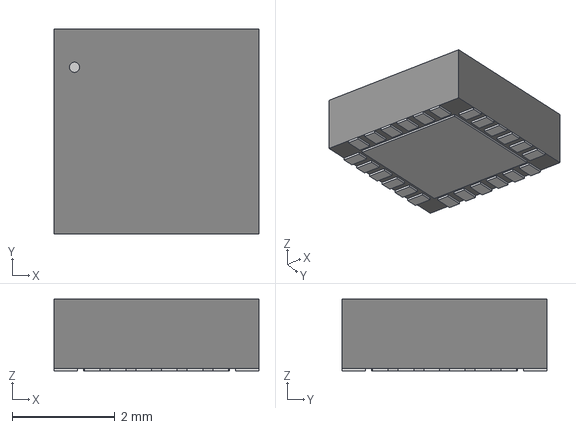
[picture p53: CAD file, 2024-03-22]
3D/QFN24_W-QFN4040-24_A1_DIO.step
3.99 x 3.99 x 1.40 mm
