OmerNazir/CustomParts/3D/Connector_RJ45_NO_LED_BOBBINLESS_c-1-406541-1-l-3d.step

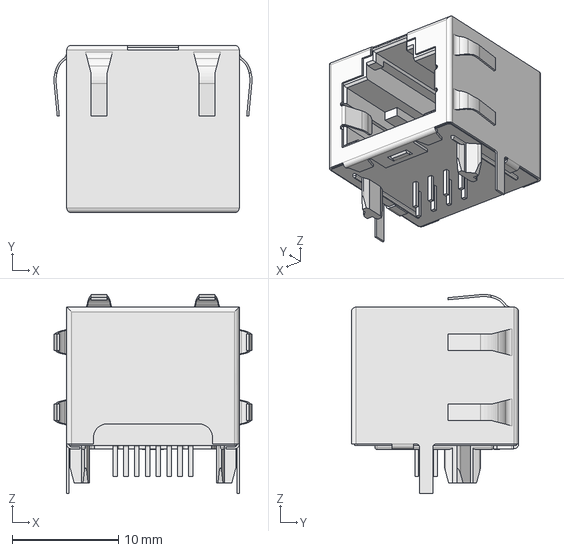
[picture p54: CAD file, 2024-03-22]
3D/Connector_RJ45_NO_LED_BOBBINLESS_c-1-406541-1-l-3d.step
18.6 x 15.7 x 18.7 mm
