OmerNazir/CustomParts/3D/Module_M2_2280.step

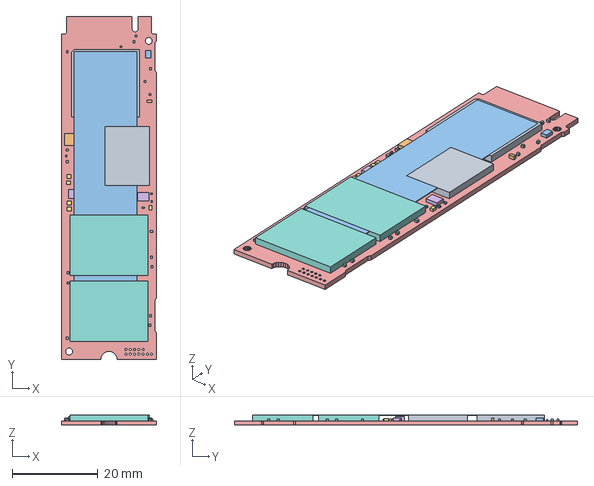
[picture p55: CAD file, 2024-03-22]
3D/Module_M2_2280.step
22.1 x 80.2 x 2.38 mm
