OmerNazir/CustomParts/3D/Battery_Supercap 5v_5F.step

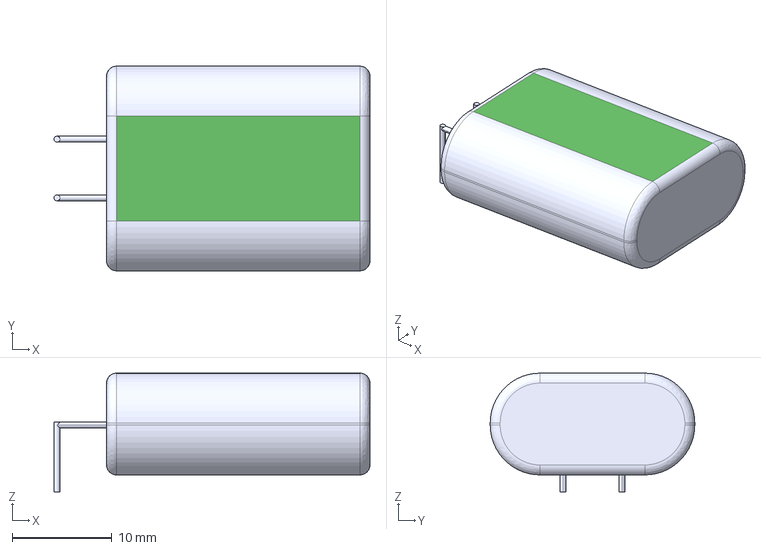
[picture p56: CAD file, 2024-03-22]
3D/Battery_Supercap 5v_5F.step
31.7 x 20.5 x 11.9 mm
