OmerNazir/CustomParts/3D/Connector_DSUB15_VGA_offset_8.63mm.step

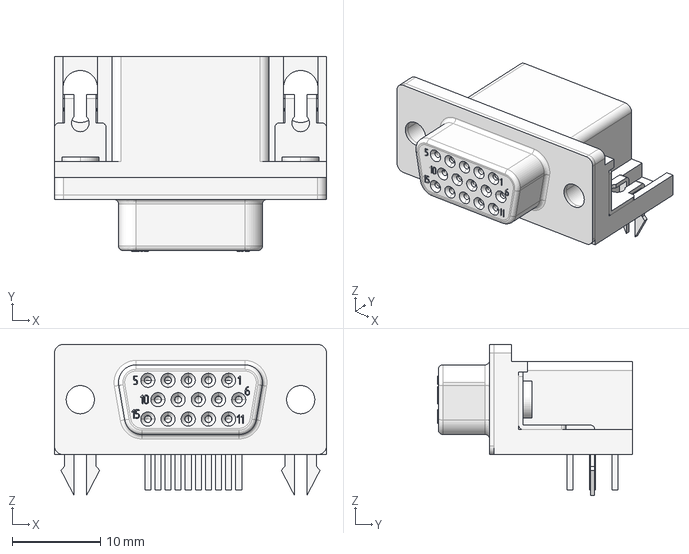
[picture p57: CAD file, 2024-03-22]
3D/Connector_DSUB15_VGA_offset_8.63mm.step
30.8 x 22.1 x 17.1 mm
