OmerNazir/CustomParts/(list of files, cad)

Other CAD files:
3D/Tact Switch_4.5x4.5.step
3D/10029449-111RLF.stp
3D/10118194-0001LF.step
3D/10118194c.stp
3D/475531001.stp
3D/692122030100_001.step
3D/75411.stp
