OmerNazir/CustomParts/(commit log)

2024-04-29 1.5mH bobin girildi
    [Inductor_Custom_1.5mH.step]
2024-05-29 pil eklendi
    [Battery_A_size_3_pin.step]
